embedinn/iotSDR/boards/iotSDR-IOT_Z7010/README.md

Manually edit Current Directory Path to include Remote APIs
