embedinn/iotSDR/boards/vivado_boards_files/iotSDR-Z7010/1.0/iot_SDR.jpg

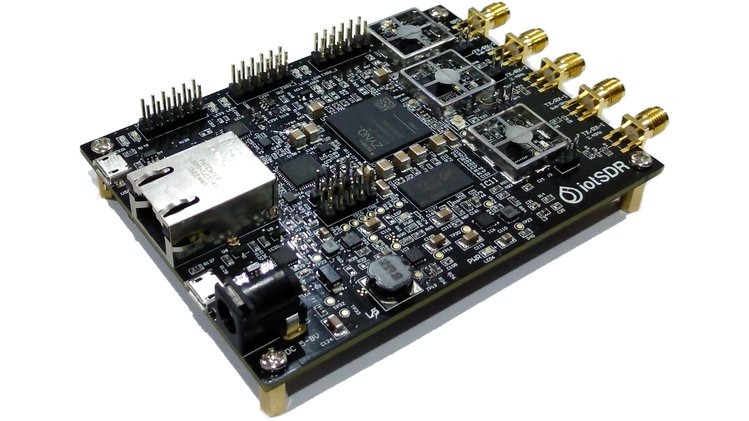
boards/vivado_boards_files/iotSDR-Z7010/1.0/iot_SDR.jpg
