embedinn/iotSDR/Support/iotSDR_BlockDesign.pdf

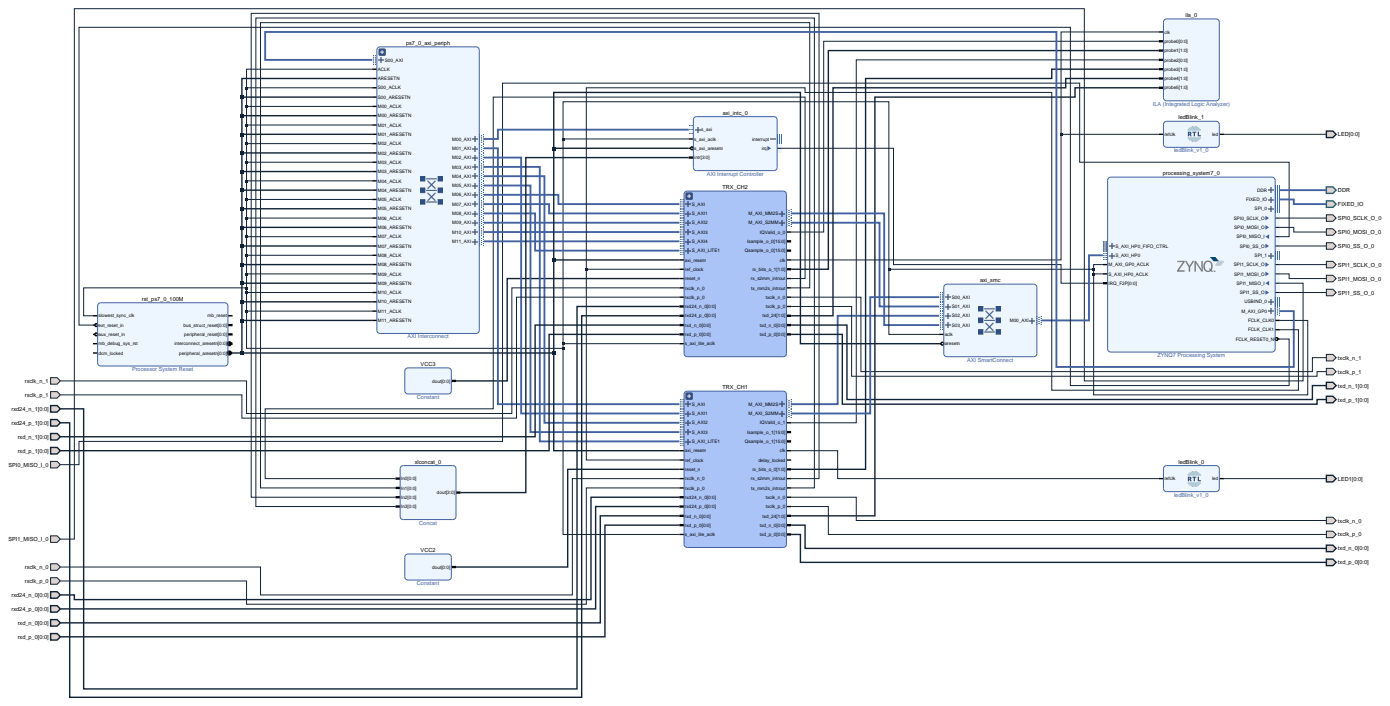
[picture p11: page 1]
DDR; FIXED_IO; LED[0:0]; LED1[0:0]; SPI0_MISO_I_0; SPI0_MOSI_O_0; SPI0_SCLK_O_0; SPI0_SS_O_0; SPI1_MISO_I_0; SPI1_MOSI_O_0; SPI1_SCLK_O_0; SPI1_SS_O_0; TRX_CH1; M_AXI_MM2S M_AXI_S2MM; S_AXI S_AXI1 S_AXI2 S_AXI3 S_AXI_LITE1; IQValid_o_1; Isample_o_1[15:0] Qsample_o_1[15:0] axi_resetn; clk; ref_clock; delay_locked; reset_n; rx_bits_o_0[1:0]; rxclk_n_0; rx_s2mm_introut; rxclk_p_0; rxd24_n_0[0:0]; rxd24_p_0[0:0]; rxd_n_0[0:0]; rxd_p_0[0:0] s_axi_lite_aclk; tx_mm2s_introut; txclk_n_0; txclk_p_0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

ILA (Integrated Logic Analyzer)

AXI Interrupt Controller

Processor System Reset
