embedinn/iotSDR/iotSDRlib/at86rf215_defs.py

# Copyright (c) 2020, embedINN
# All rights reserved.

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
# 3. Neither the name of the copyright holder nor the names of its
#    contributors may be used to endorse or promote products derived from
#    this software without specific prior written permission.

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
"""
Register identifiers for the AT86RF215 sub-GHz radio.

\author Jonathan Munoz (jonathan.munoz@inria.fr), January 2017
"""

# MACROS

IRQS_TXFE_MASK =            0x10
IRQS_TRXRDY_MASK =          0x02
IRQS_RXFS_MASK =            0x01
IRQS_RXFE_MASK =            0x02

# commands
CMD_RF_NOP =                0x0
CMD_RF_SLEEP =              0x1
CMD_RF_TRXOFF =             0x2
CMD_RF_TXPREP =             0x3
CMD_RF_TX =                 0x4
CMD_RF_RX =                 0x5
CMD_RF_RESET =              0x7
CMD_RF_IQ_MODE =            (0x1 << 4) 

# states
RF_STATE_TRXOFF =           0x2
RF_STATE_TXPREP =           0x3
RF_STATE_TX =               0x4
RF_STATE_RX =               0x5
RF_STATE_TRANSITION =       0x6
RF_STATE_RESET =            0x7

# Radio IRQ Status
IRQS_WAKEUP =               0x01
IRQS_TRXRDY =               0x02
IRQS_EDC =                  0x04
IRQS_BATLOW =               0x08
IRQS_TRXERR =               0x10
IRQS_IQIFSF =               0x20

# baseband IRQ Status
IRQS_RXFS =                 0x01
IRQS_RXFE =                 0x02
IRQS_RXAM =                 0x04
IRQS_RXEM =                 0x08
IRQS_TXFE =                 0x10
IRQS_AGCH =                 0x20
IRQS_AGCR =                 0x40
IRQS_FBLI =                 0x80

# reset command
RST_CMD =                   0x07

# register addresses (16-bit)

RG_RF09_IRQS =              [0x00, 0x00]
RG_RF24_IRQS =              [0x00, 0x01]
RG_BBC0_IRQS =              [0x00, 0x02]
RG_BBC1_IRQS =              [0x00, 0x03]
RG_RF_RST =                 [0x00, 0x05]
RG_RF_CFG =                 [0x00, 0x06]
RG_RF_CLKO =                [0x00, 0x07]
RG_RF_BMDVC =               [0x00, 0x08]
RG_RF_XOC =                 [0x00, 0x09]
RG_RF_IQIFC0 =              [0x00, 0x0A]
RG_RF_IQIFC1 =              [0x00, 0x0B]
RG_RF_IQIFC2 =              [0x00, 0x0C]
RG_RF_PN =                  [0x00, 0x0D]
RG_RF_VN =                  [0x00, 0x0E]

RG_RF09_IRQM =              [0x01, 0x00]
RG_RF09_AUXS =              [0x01, 0x01]
RG_RF09_STATE =             [0x01, 0x02]
RG_RF09_CMD =               [0x01, 0x03]
RG_RF24_CMD =               [0x02, 0x03]
RG_RF09_CS =                [0x01, 0x04]
RG_RF09_CCF0L =             [0x01, 0x05]
RG_RF09_CCF0H =             [0x01, 0x06]
RG_RF09_CNL =               [0x01, 0x07]
RG_RF09_CNM =               [0x01, 0x08]
RG_RF09_RXBWC =             [0x01, 0x09]
RG_RF09_RXDFE =             [0x01, 0x0A]
RG_RF09_AGCC =              [0x01, 0x0B]
RG_RF09_AGCS =              [0x01, 0x0C]
RG_RF09_RSSI =              [0x01, 0x0D]
RG_RF09_EDC =               [0x01, 0x0E]
RG_RF09_EDD =               [0x01, 0x0F]
RG_RF09_EDV =               [0x01, 0x10]
RG_RF09_RNDV =              [0x01, 0x11]
RG_RF09_TXCUTC =            [0x01, 0x12]
RG_RF09_TXDFE =             [0x01, 0x13]
RG_RF09_PAC =               [0x01, 0x14]

RG_RF24_IRQM =              [0x02, 0x00]
RG_RF24_AUXS =              [0x02, 0x01]
RG_RF24_STATE =             [0x02, 0x02]
RG_RF24_CMD =               [0x02, 0x03]
RG_RF24_CS =                [0x02, 0x04]
RG_RF24_CCF0L =             [0x02, 0x05]
RG_RF24_CCF0H =             [0x02, 0x06]
RG_RF24_CNL =               [0x02, 0x07]
RG_RF24_CNM =               [0x02, 0x08]
RG_RF24_RXBWC =             [0x02, 0x09]
RG_RF24_RXDFE =             [0x02, 0x0A]
RG_RF24_AGCC =              [0x02, 0x0B]
RG_RF24_AGCS =              [0x02, 0x0C]
RG_RF24_RSSI =              [0x02, 0x0D]
RG_RF24_EDC =               [0x02, 0x0E]
RG_RF24_EDD =               [0x02, 0x0F]
RG_RF24_EDV =               [0x02, 0x10]
RG_RF24_RNDV =              [0x02, 0x11]
RG_RF24_TXCUTC =            [0x02, 0x12]
RG_RF24_TXDFE =             [0x02, 0x13]
RG_RF24_PAC =               [0x02, 0x14]

RG_BBC0_IRQM =              [0x03, 0x00]
RG_BBC0_PC =                [0x03, 0x01]
RG_BBC0_PS =                [0x03, 0x02]
RG_BBC0_RXFLL =             [0x03, 0x04]
RG_BBC0_RXFLH =             [0x03, 0x05]
RG_BBC0_TXFLL =             [0x03, 0x06]
RG_BBC0_TXFLH =             [0x03, 0x07]
RG_BBC0_FBLL =              [0x03, 0x08]
RG_BBC0_FBLH =              [0x03, 0x09]
RG_BBC0_FBLIL =             [0x03, 0x0A]
RG_BBC0_FBLIH =             [0x03, 0x0B]

RG_BBC0_OFDMPHRTX =         [0x03, 0x0C]
RG_BBC0_OFDMPHRRX =         [0x03, 0x0D]
RG_BBC0_OFDMC =             [0x03, 0x0E]
RG_BBC0_OFDMSW =            [0x03, 0x0F]
RG_BBC0_OQPSKC0 =           [0x03, 0x10]
RG_BBC0_OQPSKC1 =           [0x03, 0x11]
RG_BBC0_OQPSKC2 =           [0x03, 0x12]
RG_BBC0_OQPSKC3 =           [0x03, 0x13]
RG_BBC0_OQPSKPHRTX =        [0x03, 0x14]
RG_BBC0_OQPSKPHRRX =        [0x03, 0x15]
RG_BBC0_FSKC0 =             [0x03, 0x60]
RG_BBC0_FSKC1 =             [0x03, 0x61]
RG_BBC0_FSKC2 =             [0x03, 0x62]
RG_BBC0_FSKC3 =             [0x03, 0x63]
RG_BBC0_FSKC4 =             [0x03, 0x64]
RG_BBC0_FSKPHRTX =          [0x03, 0x6A]
RG_BBC0_FSKPHRRX =          [0x03, 0x6B]
RG_BBC0_FSKDM =             [0x03, 0x72]
RG_BBC0_FSKPE0 =            [0x03, 0x73]
RG_BBC0_FSKPE1 =            [0x03, 0x74]
RG_BBC0_FSKPE2 =            [0x03, 0x75]
RG_BBC0_FSKSDF0L =          [0x03, 0x66]
RG_BBC0_FSKSDF0H =          [0x03, 0x67]
RG_BBC0_FSKSDF1L =          [0x03, 0x68]
RG_BBC0_FSKSDF1H =          [0x03, 0x69]


RG_BBC1_IRQM =              [0x04, 0x00]
RG_BBC1_PC =                [0x04, 0x01]
RG_BBC1_PS =                [0x04, 0x02]
RG_BBC1_RXFLL =             [0x04, 0x04]
RG_BBC1_RXFLH =             [0x04, 0x05]
RG_BBC1_TXFLL =             [0x04, 0x06]
RG_BBC1_TXFLH =             [0x04, 0x07]
RG_BBC1_FBLL =              [0x04, 0x08]
RG_BBC1_FBLH =              [0x04, 0x09]
RG_BBC1_FBLIL =             [0x04, 0x0A]
RG_BBC1_FBLIH =             [0x04, 0x0B]

RG_BBC1_OFDMPHRTX =         [0x04, 0x0C]
RG_BBC1_OFDMPHRRX =         [0x04, 0x0D]
RG_BBC1_OFDMC =             [0x04, 0x0E]
RG_BBC1_OFDMSW =            [0x04, 0x0F]
RG_BBC1_OQPSKC0 =           [0x04, 0x10]
RG_BBC1_OQPSKC1 =           [0x04, 0x11]
RG_BBC1_OQPSKC2 =           [0x04, 0x12]
RG_BBC1_OQPSKC3 =           [0x04, 0x13]
RG_BBC1_OQPSKPHRTX =        [0x04, 0x14]
RG_BBC1_OQPSKPHRRX =        [0x04, 0x15]
RG_BBC1_FSKC0 =             [0x04, 0x60]
RG_BBC1_FSKC1 =             [0x04, 0x61]
RG_BBC1_FSKC2 =             [0x04, 0x62]
RG_BBC1_FSKC3 =             [0x04, 0x63]
RG_BBC1_FSKC4 =             [0x04, 0x64]
RG_BBC1_FSKPHRTX =          [0x04, 0x6A]
RG_BBC1_FSKPHRRX =          [0x04, 0x6B]
RG_BBC1_FSKDM =             [0x04, 0x72]
RG_BBC1_FSKPE0 =            [0x04, 0x73]
RG_BBC1_FSKPE1 =            [0x04, 0x74]
RG_BBC1_FSKPE2 =            [0x04, 0x75]
RG_BBC1_FSKSDF0L =          [0x04, 0x66]
RG_BBC1_FSKSDF0H =          [0x04, 0x67]
RG_BBC1_FSKSDF1L =          [0x04, 0x68]
RG_BBC1_FSKSDF1H =          [0x04, 0x69]

RG_BBC0_FBRXS =             [0x20, 0x00]
RG_BBC0_FBRXE =             [0x27, 0xFE]
RG_BBC0_FBTXS =             [0x28, 0x00]
RG_BBC0_FBTXE =             [0x2F, 0xFE]

RG_BBC1_FBRXS =             [0x30, 0x00]
RG_BBC1_FBRXE =             [0x37, 0xFE]
RG_BBC1_FBTXS =             [0x38, 0x00]
RG_BBC1_FBTXE =             [0x3F, 0xFE]

OFDMPHRRX_MCS_MASK =        0x07

modulations_settings_ch_spacing = {
    '2fsk_50kbps_FEC_200kHz'     : [200, 863125],
    '2fsk_100kbps_FEC_400kHz'    : [400, 863225],
    '4fsk_200kbps_FEC_400kHz'    : [400, 863225],
    '2fsk_50kbps_200kHz'         : [200,863125],
    '2fsk_100kbps_400kHz'        : [400,863225],
    '4fsk_200kbps_400kHz'        : [400,863225],
    'ofdm_100kbps_1200kHz_mcs0'  : [1200,863625],
    'ofdm_200kbps_1200kHz_mcs1'  : [1200,863625],
    'ofdm_400kbps_1200kHz_mcs2'  : [1200,863625],
    'ofdm_800kbps_1200kHz_mcs3'  : [1200,863625],
    'ofdm_50kbps_800kHz_mcs0'    : [800,863425],
    'ofdm_100kbps_800kHz_mcs1'   : [800,863425],
    'ofdm_200kbps_800kHz_mcs2'   : [800,863425],
    'ofdm_400kbps_800kHz_mcs3'   : [800,863425],
    'ofdm_600kbps_800kHz_mcs4'   : [800,863425],
    'ofdm_800kbps_800kHz_mcs5'   : [800,863425],
    'ofdm_50kbps_400kHz_mcs1'    : [400,863225],
    'ofdm_100kbps_400kHz_mcs2'   : [400,863225],
    'ofdm_200kbps_400kHz_mcs3'   : [400,863225],
    'ofdm_300kbps_400kHz_mcs4'   : [400,863225],
    'ofdm_400kbps_400kHz_mcs5'   : [400,863225],
    'ofdm_600kbps_400kHz_mcs6'   : [400,863225],
    'ofdm_50kbps_200kHz_mcs2'    : [200,863125],
    'ofdm_100kbps_200kHz_mcs3'   : [200,863125],
    'ofdm_150kbps_200kHz_mcs4'   : [200,863125],
    'ofdm_200kbps_200kHz_mcs5'   : [200,863125],
    'ofdm_300kbps_200kHz_mcs6'   : [200,863125],
    'oqpsk_6.25kbps_600kHz'      : [100,868300], # I had 600 kHz, but I think it is wrong
    'oqpsk_12.5kbps_600kHz'      : [100,868300], #, I had 600 kHz, but I think it is wrong
    'oqpsk_25kbps_600kHz'        : [100,868300], # I had 600 kHz, but I think it is wrong
    'oqpsk_50kbps_600kHz'        : [100,868300]  # I had 600 kHz, but I think it is wrong
    }

modulations_settings = {
    # fsk_option1_FEC
    '2fsk_50kbps_FEC_200kHz': [
        (RG_RF09_CMD,           0x02),  # we make sure we are in the trxoff state
        (RG_RF09_IRQM,          0x1F),  # TRXERR, BATLOW, EDC, TRXRDY, WAKEUP interrupts enabled
        (RG_RF24_IRQM,          0x00),
        (RG_RF09_RXBWC,         0x00),
        (RG_RF09_RXDFE,         0x2A),  # RCUT = 1, bits 5-7. bit 4 not used.
        (RG_RF09_AGCC,          0x01),
        (RG_RF09_AGCS,          0x37),
        (RG_RF09_EDD,           0x7A),
        (RG_RF09_TXCUTC,        0xC0),
        (RG_RF09_TXDFE,         0x98),
        (RG_RF09_PAC,           0x74),  # // Tx Power 5 bits >>. 0x64 = txPwr=>0x04, max: 0x1F. 0x14~8 dBm
        (RG_BBC0_IRQM,          0x12),  # TXFE, RXFE, interrupts enabled
        (RG_BBC1_IRQM,          0x00),
        (RG_BBC0_PC,            0x15),  # // NO FCS FILTER in RX, FCS automatically added in TX, 32 bits FCS, FSK.
        (RG_BBC0_FSKDM,         0x01),  # //Direct modulation enabled and Pre-emphasis disabled.
        (RG_BBC0_FSKC0,         0xD6),
        (RG_BBC0_FSKC1,         0x00),
        # (RG_BBC0_FSKC2,         0x41),  # NRNSC and Interleaving
        (RG_BBC0_FSKC3,         0x85),
        (RG_BBC0_FSKC4,         0x0A),  # //FEC enabled. IEEE MODE
        (RG_BBC0_FSKPE0,        0x02),
        (RG_BBC0_FSKPE1,        0x03),
        (RG_BBC0_FSKPE2,        0xFC),
        (RG_BBC0_FSKPHRTX,      0x00)],

    # fsk_option2_FEC
    '2fsk_100kbps_FEC_400kHz': [
        (RG_RF09_CMD,           0x02),  # //we make sure we are in the trxoff state
        (RG_RF09_IRQM,          0x1F),  # // TRXERR, BATLOW, EDC, TRXRDY, WAKEUP interrupts enabled
        (RG_RF24_IRQM,          0x00),
        (RG_RF09_RXBWC,         0x03),
        (RG_RF09_RXDFE,         0x25),  # RCUT = 1, bits 5-7. bit 4 not used.
        (RG_RF09_AGCC,          0x01),
        (RG_RF09_AGCS,          0x37),
        (RG_RF09_EDD,           0x7A),
        (RG_RF09_TXCUTC,        0x83),
        (RG_RF09_TXDFE,         0x94),
        (RG_RF09_PAC,           0x74),  # // Tx Power 5 bits >>. 0x64 = txPwr=>0x04, max: 0x1F. 0x14~8 dBm
        (RG_BBC0_IRQM,          0x12),  # // TXFE, RXEM, RXAM, RXFE, RXFS interrupts enabled
        (RG_BBC1_IRQM,          0x00),
        (RG_BBC0_PC,            0x15),  # // NO FCS FILTER in RX, FCS automatically added in TX, 32 bits FCS, FSK.
        (RG_BBC0_FSKDM,         0x01),  # //Direct modulation enabled and Pre-emphasis disabled.
        (RG_BBC0_FSKC0,         0xD6),
        (RG_BBC0_FSKC1,         0x01),
        # (RG_BBC0_FSKC2,         0x41),  # NRNSC and Interleaving
        (RG_BBC0_FSKC3,         0x85),
        (RG_BBC0_FSKC4,         0x0A),  # //FEC enabled. IEEE MODE
        (RG_BBC0_FSKPE0,        0x0E),
        (RG_BBC0_FSKPE1,        0x0F),
        (RG_BBC0_FSKPE2,        0xF0),
        (RG_BBC0_FSKPHRTX,      0x00)],

    # fsk_option3_FEC
    '4fsk_200kbps_FEC_400kHz': [
        (RG_RF09_CMD,           0x02),  # //we make sure we are in the trxoff state
        (RG_RF09_IRQM,          0x1F),  # // TRXERR, BATLOW, EDC, TRXRDY, WAKEUP interrupts enabled
        (RG_RF24_IRQM,          0x00),
        (RG_RF09_RXBWC,         0x03),  # //IF shift, 200 kHz bandwidth
        (RG_RF09_RXDFE,         0x25),  # //find the right values
        (RG_RF09_AGCC,          0x01),
        (RG_RF09_AGCS,          0x37),
        (RG_RF09_EDD,           0x7A),
        (RG_RF09_TXCUTC,        0x83),  #
        (RG_RF09_TXDFE,         0x94),  # //find the right values
        (RG_RF09_PAC,           0x74),  # // Tx Power 5 bits >>. 0x64 = txPwr=>0x04, max: 0x1F. 0x14~8 dBm
        (RG_BBC0_IRQM,          0x12),  # // TXFE, RXFE interrupts enabled.  RXFS , RXEM, RXAM, disabled
        (RG_BBC1_IRQM,          0x00),
        (RG_BBC0_PC,            0x15),  # // NO FCS FILTER in RX, FCS automatically added in TX, 32 bits FCS, FSK.
        (RG_BBC0_FSKDM,         0x01),  # //Direct modulation enabled and Pre-emphasis disabled.
        (RG_BBC0_FSKSDF0L,      0xBE),
        (RG_BBC0_FSKSDF0H,      0xFF),
        # (RG_BBC0_FSKSDF1L,      0xAE),
        # (RG_BBC0_FSKSDF1H,      0xBF),
        (RG_BBC0_FSKC0,         0xD7),
        (RG_BBC0_FSKC1,         0x01),  #  1 = 100 kHz symbol rate, 3 = 200 kHz
        # (RG_BBC0_FSKC2,         0x41),  # NRNSC and Interleaving
        (RG_BBC0_FSKC3,         0x85),
        (RG_BBC0_FSKC4,         0x22),
        (RG_BBC0_FSKPE0,        0x0E),
        (RG_BBC0_FSKPE1,        0x0F),
        (RG_BBC0_FSKPE2,        0xF0),
        (RG_BBC0_FSKPHRTX,      0x00)],

    # fsk_option1
    '2fsk_50kbps_200kHz': [
        (RG_RF09_CMD,           0x02),  # //we make sure we are in the trxoff state
        (RG_RF09_IRQM,          0x1F),  # // TRXERR, BATLOW, EDC, TRXRDY, WAKEUP interrupts enabled
        (RG_RF24_IRQM,          0x00),
        (RG_RF09_RXBWC,         0x00), # 0 IFS, 50 kHz symbol rate
        (RG_RF09_RXDFE,         0x2A), # RCUT = 1 , SR = 10
        (RG_RF09_AGCC,          0x01),
        (RG_RF09_AGCS,          0x37),
        (RG_RF09_EDD,           0x7A),
        (RG_RF09_TXCUTC,        0xC0),
        (RG_RF09_TXDFE,         0x98),
        (RG_RF09_PAC,           0x74),  # // Tx Power 5 bits >>. 0x64 = txPwr=>0x04, max: 0x1F. 0x14~8 dBm
        (RG_BBC0_IRQM,          0x12),  # // TXFE, RXEM, RXAM, RXFE, RXFS interrupts enabled
        (RG_BBC1_IRQM,          0x00),
        (RG_BBC0_PC,            0x15),  # // NO FCS FILTER in RX, FCS automatically added in TX, 32 bits FCS, FSK.
        (RG_BBC0_FSKDM,         0x01),  # //Direct modulation enabled and Pre-emphasis disabled.
        (RG_BBC0_FSKC0,         0xD6),
        (RG_BBC0_FSKC1,         0x00),
        # (RG_BBC0_FSKC2,         0x41),  # NRNSC and Interleaving
        (RG_BBC0_FSKC3,         0x85),
        (RG_BBC0_FSKC4,         0x00),  # //FEC disabled. IEEE MODE
        (RG_BBC0_FSKPE0,        0x02),
        (RG_BBC0_FSKPE1,        0x03),
        (RG_BBC0_FSKPE2,        0xFC),
        (RG_BBC0_FSKPHRTX,      0x08)],  # using SDF 1

    # fsk_option2
    '2fsk_100kbps_400kHz': [
        (RG_RF09_CMD,           0x02),  # //we make sure we are in the trxoff state
        (RG_RF09_IRQM,          0x1F),  # // TRXERR, BATLOW, EDC, TRXRDY, WAKEUP interrupts enabled
        (RG_RF24_IRQM,          0x00),
        (RG_RF09_RXBWC,         0x03),  # 0 IFS, 100 kHz symbol rate
        (RG_RF09_RXDFE,         0x25),  # RCUT = 1 , SR = 5
        (RG_RF09_AGCC,          0x01),
        (RG_RF09_AGCS,          0x37),
        (RG_RF09_EDD,           0x7A),
        (RG_RF09_TXCUTC,        0x83),
        (RG_RF09_TXDFE,         0x94),
        (RG_RF09_PAC,           0x74),  # // Tx Power 5 bits >>. 0x64 = txPwr=>0x04, max: 0x1F. 0x14~8 dBm
        (RG_BBC0_IRQM,          0x12),  # // TXFE, RXEM, RXAM, RXFE, RXFS interrupts enabled
        (RG_BBC1_IRQM,          0x00),
        (RG_BBC0_PC,            0x15),  # // NO FCS FILTER in RX, FCS automatically added in TX, 32 bits FCS, FSK.
        (RG_BBC0_FSKDM,         0x01),  # //Direct modulation enabled and Pre-emphasis disabled.
        (RG_BBC0_FSKC0,         0xD6),
        (RG_BBC0_FSKC1,         0x01),
        # (RG_BBC0_FSKC2,         0x41),  # NRNSC and Interleaving
        (RG_BBC0_FSKC3,         0x85),
        (RG_BBC0_FSKC4,         0x00),  # //FEC disabled. IEEE MODE
        (RG_BBC0_FSKPE0,        0x0E),
        (RG_BBC0_FSKPE1,        0x0F),
        (RG_BBC0_FSKPE2,        0xF0),
        (RG_BBC0_FSKPHRTX,      0x08)],  # using SDF1

    # fsk_option3
    '4fsk_200kbps_400kHz': [
        (RG_RF09_CMD,           0x02),  # //we make sure we are in the trxoff state
        (RG_RF09_IRQM,          0x1F),  # // TRXERR, BATLOW, EDC, TRXRDY, WAKEUP interrupts enabled
        (RG_RF24_IRQM,          0x00),
        (RG_RF09_RXBWC,         0x03),  # //IFS 1, 200 kHz
        (RG_RF09_RXDFE,         0x25),  # # RCUT = 2 , SR = 4
        (RG_RF09_AGCC,          0x01),
        (RG_RF09_AGCS,          0x37),
        (RG_RF09_EDD,           0x7A),
        (RG_RF09_TXCUTC,        0x83),  #
        (RG_RF09_TXDFE,         0x94),  #
        (RG_RF09_PAC,           0x74),  # // Tx Power 5 bits >>. 0x64 = txPwr=>0x04, max: 0x1F. 0x14~8 dBm
        (RG_BBC0_IRQM,          0x12),  # // TXFE, RXEM, RXAM, RXFE, RXFS interrupts enabled
        (RG_BBC1_IRQM,          0x00),
        (RG_BBC0_PC,            0x15),  # // NO FCS FILTER in RX, FCS automatically added in TX, 32 bits FCS, FSK.
        (RG_BBC0_FSKDM,         0x01),  # //Direct modulation enabled and Preemphasis disabled.
        (RG_BBC0_FSKSDF0L,      0xEB),
        (RG_BBC0_FSKSDF0H,      0xAA),
        # (RG_BBC0_FSKSDF1L,      0xAE),
        # (RG_BBC0_FSKSDF1H,      0xBF),
        (RG_BBC0_FSKC0,         0xD7),
        (RG_BBC0_FSKC1,         0x01),  #  1 = 200 kHz symbol rate, 3 = 400 kHz
        # (RG_BBC0_FSKC2,         0x41),  # NRNSC and Interleaving
        (RG_BBC0_FSKC3,         0x85),
        (RG_BBC0_FSKC4,         0x20),  # FEC disabled
        (RG_BBC0_FSKPE0,        0x0E),
        (RG_BBC0_FSKPE1,        0x0F),
        (RG_BBC0_FSKPE2,        0xF0),
        (RG_BBC0_FSKPHRTX,      0x00)],

    # oqpsk_rate0
    'oqpsk_6.25kbps_600kHz': [
        (RG_BBC0_PC,            0x17),
        (RG_BBC0_OQPSKPHRTX,    0x00),  # MR-OQPSK, rate mode 0
        (RG_BBC0_OQPSKC0,       0x10),  # 100kchips/s, RC-0.8 shaping, direct-modulation enabled
        (RG_BBC0_OQPSKC1,       0xB8),#// MINIMUM preamble-detection sensitivity for SUN-O-QPSK, MAXIMUM for LEGACY OQPSK, rx-override enabled
        (RG_BBC0_OQPSKC2,       0x04),#// listen for MR-OQPSK frames only
        (RG_BBC0_OQPSKC3,       0x00),#// legacy OQPSK, search for SFD_1 only
        (RG_BBC0_IRQM,          0x13),  # // TXFE, RXFE, RXFS interrupts enabled
        (RG_BBC1_IRQM,          0x00),
        (RG_RF09_IRQM,          0x12),  # // TRXERR, TRXRDY interrupts enabled
        (RG_RF24_IRQM,          0x00),
        (RG_RF09_RXBWC,         0x00),  # Rx BW 160kHz, IF 250kHz
        (RG_RF09_RXDFE,         0x2A),  # //
        (RG_RF09_AGCC,          0x21),
        (RG_RF09_EDD,           0x2B),
        (RG_RF09_AGCS,          0x77),
        (RG_RF09_TXCUTC,        0xC7),  # .PARAMP = 3, .LPFCUT = 7
        (RG_RF09_TXDFE,         0x7A),  # // .SR = 0xA, .RCUT = 3
        (RG_RF09_PAC,           0x75)],  # Tx Power 5 bits >>. 0x64 = txPwr=>0x04, max: 0x1F. # 0x15~8 dBm

    # oqpsk_rate1
    'oqpsk_12.5kbps_600kHz': [
        (RG_BBC0_PC,            0x17),
        (RG_BBC0_OQPSKPHRTX,    0x02),  #  MR-OQPSK, rate mode 1
        (RG_BBC0_OQPSKC0,       0x10),  #  100kchips/s, RC-0.8 shaping, direct-modulation enabled
        (RG_BBC0_OQPSKC1,       0xB8),#// MINIMUM preamble-detection sensitivity for SUN-O-QPSK, MAXIMUM for LEGACY OQPSK, rx-override enabled
        (RG_BBC0_OQPSKC2,       0x00),  # listen for MR-OQPSK frames only
        (RG_BBC0_OQPSKC3,       0x00), #  legacy OQPSK, search for SFD_1 only
        (RG_BBC0_IRQM,          0x13),  # // TXFE, RXFE, RXFS interrupts enabled
        (RG_BBC1_IRQM,          0x00),
        (RG_RF09_IRQM,          0x12),  # // TRXERR, TRXRDY interrupts enabled
        (RG_RF24_IRQM,          0x00),
        (RG_RF09_RXBWC,         0x00),  # //  Rx BW 160kHz, IF 250kHz
        (RG_RF09_RXDFE,         0x2A),  # //
        (RG_RF09_AGCC,          0x21),
        (RG_RF09_EDD,           0x2B),
        (RG_RF09_AGCS,          0x77),
        (RG_RF09_TXCUTC,        0xC7),  # // .PARAMP = 3, .LPFCUT = 7
        (RG_RF09_TXDFE,         0x7A),  # // .SR = 0xA, .RCUT = 3
        (RG_RF09_PAC,           0x75)],  # Tx Power 5 bits >>. 0x64 = txPwr=>0x04, max: 0x1F. # 0x15~8 dBm

    # oqpsk_rate2
    'oqpsk_25kbps_600kHz': [
        (RG_BBC0_PC,            0x17),
        (RG_BBC0_OQPSKPHRTX,    0x04),  # // MR-OQPSK, rate mode 2
        (RG_BBC0_OQPSKC0,       0x10),  # // 100kchips/s, RC-0.8 shaping, direct-modulation enabled
        (RG_BBC0_OQPSKC1,       0xB8),  #// MINIMUM preamble-detection sensitivities, rx-override disabled
        (RG_BBC0_OQPSKC2,       0x04), # // listen for MR-OQPSK frames only
        (RG_BBC0_OQPSKC3,       0x00), # // legacy OQPSK, search for SFD_1 only
        (RG_BBC0_IRQM,          0x13),  # // TXFE, RXFE, RXFS interrupts enabled
        (RG_BBC1_IRQM,          0x00),
        (RG_RF09_IRQM,          0x12),  # // TRXERR, TRXRDY interrupts enabled
        (RG_RF24_IRQM,          0x00),
        (RG_RF09_RXBWC,         0x00),  # //  Rx BW 160kHz, IF 250kHz
        (RG_RF09_RXDFE,         0x2A),  # //
        (RG_RF09_AGCC,          0x21),
        (RG_RF09_EDD,           0x2B),
        (RG_RF09_AGCS,          0x77),
        (RG_RF09_TXCUTC,        0xC7),  # # .PARAMP = 3, .LPFCUT = 7
        (RG_RF09_TXDFE,         0x7A),  # # .SR = 0xA, .RCUT = 3
        (RG_RF09_PAC,           0x75)],  # Tx Power 5 bits >>. 0x64 = txPwr=>0x04, max: 0x1F. # 0x15~8 dBm

    # oqpsk_rate3
    'oqpsk_50kbps_600kHz': [
        (RG_BBC0_PC,            0x17),
        (RG_BBC0_OQPSKPHRTX,    0x06),  # # MR-OQPSK, rate mode 3
        (RG_BBC0_OQPSKC0,       0x10),  ## 100kchips/s, RC-0.8 shaping, direct-modulation enabled
        (RG_BBC0_OQPSKC1,       0xB8),  # MINIMUM preamble-detection sensitivities, rx-override disabled
        (RG_BBC0_OQPSKC2,       0x00),  # listen for MR-OQPSK frames only
        (RG_BBC0_OQPSKC3,       0x00),  # legacy OQPSK, search for SFD_1 only
        (RG_BBC0_IRQM,          0x13),  # # TXFE, RXFE, RXFS interrupts enabled
        (RG_BBC1_IRQM,          0x00),
        (RG_RF09_IRQM,          0x12),  # # TRXERR, TRXRDY interrupts enabled
        (RG_RF24_IRQM,          0x00),
        (RG_RF09_RXBWC,         0x00),  # #  Rx BW 160kHz, IF 250kHz
        (RG_RF09_RXDFE,         0x2A),  # #
        (RG_RF09_AGCC,          0x21),
        (RG_RF09_EDD,           0x2B),
        (RG_RF09_AGCS,          0x77),
        (RG_RF09_TXCUTC,        0xC7),  # # .PARAMP = 3, .LPFCUT = 7
        (RG_RF09_TXDFE,         0x7A),  # # .SR = 0xA, .RCUT = 3
        (RG_RF09_PAC,           0x75)],  # Tx Power 5 bits >>. 0x64 = txPwr=>0x04, max: 0x1F. # 0x15~8 dBm

    # subGHz_ofdm_1_mcs0
    'subGHz_ofdm_100kbps_1200kHz_mcs0': [
        (RG_RF09_CMD,           0x02),
        (RG_RF09_IRQM,          0x1F),
        (RG_RF24_IRQM,          0x00),
        (RG_RF09_RXBWC,         0x19),
        (RG_RF09_RXDFE,         0x83),
        # (RG_RF09_AGCC,          0x11),
        (RG_RF09_EDD,           0x7A),
        (RG_RF09_TXCUTC,        0x0A),  # recommended value (0x0B)
        (RG_RF09_TXDFE,         0x83),
        (RG_RF09_PAC,           0x7D),  # Tx Power 5 bits >>. 0x64 = txPwr=>0x04, max: 0x1F. # 0x1D~8dBm
        (RG_BBC0_IRQM,          0x12),
        (RG_BBC1_IRQM,          0x00),
        (RG_BBC0_PC,            0x16),  # NO FCS FILTER in RX, FCS automatically added in TX
        (RG_BBC0_OFDMC,         0x00),
        (RG_BBC0_OFDMPHRTX,     0x00)],

    # subGHz_ofdm_1_mcs1
    'subGHz_ofdm_200kbps_1200kHz_mcs1': [
        (RG_RF09_CMD,           0x02),
        (RG_RF09_IRQM,          0x1F),
        (RG_RF24_IRQM,          0x00),
        (RG_RF09_RXBWC,         0x19),
        (RG_RF09_RXDFE,         0x83),
        # (RG_RF09_AGCC,          0x11),
        (RG_RF09_EDD,           0x7A),
        (RG_RF09_TXCUTC,        0x0A),  # recommended value (0x0B)
        (RG_RF09_TXDFE,         0x83),
        (RG_RF09_PAC,           0x7D),  # Tx Power 5 bits >>. 0x64 = txPwr=>0x04, max: 0x1F. # 0x1D~8dBm
        (RG_BBC0_IRQM,          0x12),
        (RG_BBC1_IRQM,          0x00),
        (RG_BBC0_PC,            0x16),  # NO FCS FILTER in RX, FCS automatically added in TX
        (RG_BBC0_OFDMC,         0x00),
        (RG_BBC0_OFDMPHRTX,     0x01)],

    # subGHz_ofdm_1_mcs2
    'subGHz_ofdm_400kbps_1200kHz_mcs2': [
        (RG_RF09_CMD,           0x02),
        (RG_RF09_IRQM,          0x1F),
        (RG_RF24_IRQM,          0x00),
        (RG_RF09_RXBWC,         0x19),
        (RG_RF09_RXDFE,         0x83),
        # (RG_RF09_AGCC,          0x11),
        (RG_RF09_EDD,           0x7A),
        (RG_RF09_TXCUTC,        0x0A),  # recommended value (0x0B)
        (RG_RF09_TXDFE,         0x83),
        (RG_RF09_PAC,           0x7D),  # Tx Power 5 bits >>. 0x64 = txPwr=>0x04, max: 0x1F. # 0x1D~8dBm
        (RG_BBC0_IRQM,          0x12),
        (RG_BBC1_IRQM,          0x00),
        (RG_BBC0_PC,            0x16),  # NO FCS FILTER in RX, FCS automatically added in TX
        (RG_BBC0_OFDMC,         0x00),
        (RG_BBC0_OFDMPHRTX,     0x02)],

    # subGHz_ofdm_1_mcs3
    'subGHz_ofdm_800kbps_1200kHz_mcs3': [
        (RG_RF09_CMD,           0x02),
        (RG_RF09_IRQM,          0x1F),
        (RG_RF24_IRQM,          0x00),
        (RG_RF09_RXBWC,         0x19),
        (RG_RF09_RXDFE,         0x83),
        # (RG_RF09_AGCC,          0x11),
        (RG_RF09_EDD,           0x7A),
        (RG_RF09_TXCUTC,        0x0A),  # recommended value (0x0B)
        (RG_RF09_TXDFE,         0x83),
        (RG_RF09_PAC,           0x7D),  # Tx Power 5 bits >>. 0x64 = txPwr=>0x04, max: 0x1F. # 0x1D~8dBm
        (RG_BBC0_IRQM,          0x12),
        (RG_BBC1_IRQM,          0x00),
        (RG_BBC0_PC,            0x16),  # NO FCS FILTER in RX, FCS automatically added in TX
        (RG_BBC0_OFDMC,         0x00),
        (RG_BBC0_OFDMPHRTX,     0x03)],

    # subGHz_ofdm_2_mcs0
    'subGHz_ofdm_50kbps_800kHz_mcs0': [
        (RG_RF09_CMD,           0x02),
        (RG_RF09_IRQM,          0x1F),
        (RG_RF24_IRQM,          0x00),
        (RG_RF09_RXBWC,         0x17),
        (RG_RF09_RXDFE,         0x43),
        # (RG_RF09_AGCC,          0x11),
        (RG_RF09_EDD,           0x7A),
        (RG_RF09_TXCUTC,        0x08),  # recommended value ()
        (RG_RF09_TXDFE,         0x63),
        (RG_RF09_PAC,           0x7C),  # Tx Power 5 bits >>. 0x64 = txPwr=>0x04, max: 0x1F. # 0x1C~8dBm
        (RG_BBC0_IRQM,          0x12),
        (RG_BBC1_IRQM,          0x00),
        (RG_BBC0_PC,            0x16),  # NO FCS FILTER in RX, FCS automatically added in TX
        (RG_BBC0_OFDMC,         0x01),
        (RG_BBC0_OFDMPHRTX,     0x00)],

    # subGHz_ofdm_2_mcs1
    'subGHz_ofdm_100kbps_800kHz_mcs1': [
        (RG_RF09_CMD,           0x02),
        (RG_RF09_IRQM,          0x1F),
        (RG_RF24_IRQM,          0x00),
        (RG_RF09_RXBWC,         0x17),
        (RG_RF09_RXDFE,         0x43),
        # (RG_RF09_AGCC,          0x11),
        (RG_RF09_EDD,           0x7A),
        (RG_RF09_TXCUTC,        0x08),  # recommended value ()
        (RG_RF09_TXDFE,         0x63),
        (RG_RF09_PAC,           0x7C),  # Tx Power 5 bits >>. 0x64 = txPwr=>0x04, max: 0x1F. # 0x1C~8dBm
        (RG_BBC0_IRQM,          0x12),
        (RG_BBC1_IRQM,          0x00),
        (RG_BBC0_PC,            0x16),  # NO FCS FILTER in RX, FCS automatically added in TX
        (RG_BBC0_OFDMC,         0x01),
        (RG_BBC0_OFDMPHRTX,     0x01)],

    # subGHz_ofdm_2_mcs2
    'subGHz_ofdm_200kbps_800kHz_mcs2': [
        (RG_RF09_CMD,           0x02),
        (RG_RF09_IRQM,          0x1F),
        (RG_RF24_IRQM,          0x00),
        (RG_RF09_RXBWC,         0x17),
        (RG_RF09_RXDFE,         0x43),
        # (RG_RF09_AGCC,          0x11),
        (RG_RF09_EDD,           0x7A),
        (RG_RF09_TXCUTC,        0x08),  # recommended value ()
        (RG_RF09_TXDFE,         0x63),
        (RG_RF09_PAC,           0x7C),  # Tx Power 5 bits >>. 0x64 = txPwr=>0x04, max: 0x1F. # 0x1C~8dBm
        (RG_BBC0_IRQM,          0x12),
        (RG_BBC1_IRQM,          0x00),
        (RG_BBC0_PC,            0x16),  # NO FCS FILTER in RX, FCS automatically added in TX
        (RG_BBC0_OFDMC,         0x01),
        (RG_BBC0_OFDMPHRTX,     0x02)],

    # subGHz_ofdm_2_mcs3
    'subGHz_ofdm_400kbps_800kHz_mcs3': [
        (RG_RF09_CMD,           0x02),
        (RG_RF09_IRQM,          0x1F),
        (RG_RF24_IRQM,          0x00),
        (RG_RF09_RXBWC,         0x17),
        (RG_RF09_RXDFE,         0x43),
        # (RG_RF09_AGCC,          0x11),
        (RG_RF09_EDD,           0x7A),
        (RG_RF09_TXCUTC,        0x08),  # recommended value ()
        (RG_RF09_TXDFE,         0x63),
        (RG_RF09_PAC,           0x7C),  # Tx Power 5 bits >>. 0x64 = txPwr=>0x04, max: 0x1F. # 0x1C~8dBm
        (RG_BBC0_IRQM,          0x12),
        (RG_BBC1_IRQM,          0x00),
        (RG_BBC0_PC,            0x16),  # NO FCS FILTER in RX, FCS automatically added in TX
        (RG_BBC0_OFDMC,         0x01),
        (RG_BBC0_OFDMPHRTX,     0x03)],

    # subGHz_ofdm_2_mcs4
    'subGHz_ofdm_600kbps_800kHz_mcs4': [
        (RG_RF09_CMD,           0x02),
        (RG_RF09_IRQM,          0x1F),
        (RG_RF24_IRQM,          0x00),
        (RG_RF09_RXBWC,         0x17),
        (RG_RF09_RXDFE,         0x43),
        # (RG_RF09_AGCC,          0x11),
        (RG_RF09_EDD,           0x7A),
        (RG_RF09_TXCUTC,        0x08),  # recommended value ()
        (RG_RF09_TXDFE,         0x63),
        (RG_RF09_PAC,           0x7C),  # Tx Power 5 bits >>. 0x64 = txPwr=>0x04, max: 0x1F. # 0x1C~8dBm
        (RG_BBC0_IRQM,          0x12),
        (RG_BBC1_IRQM,          0x00),
        (RG_BBC0_PC,            0x16),  # NO FCS FILTER in RX, FCS automatically added in TX
        (RG_BBC0_OFDMC,         0x01),
        (RG_BBC0_OFDMPHRTX,     0x04)],

    # subGHz_ofdm_2_mcs5
    'subGHz_ofdm_800kbps_800kHz_mcs5': [
        (RG_RF09_CMD,           0x02),
        (RG_RF09_IRQM,          0x1F),
        (RG_RF24_IRQM,          0x00),
        (RG_RF09_RXBWC,         0x17),
        (RG_RF09_RXDFE,         0x43),
        # (RG_RF09_AGCC,          0x11),
        (RG_RF09_EDD,           0x7A),
        (RG_RF09_TXCUTC,        0x08),  # recommended value ()
        (RG_RF09_TXDFE,         0x63),
        (RG_RF09_PAC,           0x7C),  # Tx Power 5 bits >>. 0x64 = txPwr=>0x04, max: 0x1F. # 0x1C~8dBm
        (RG_BBC0_IRQM,          0x12),
        (RG_BBC1_IRQM,          0x00),
        (RG_BBC0_PC,            0x16),  # NO FCS FILTER in RX, FCS automatically added in TX
        (RG_BBC0_OFDMC,         0x01),
        (RG_BBC0_OFDMPHRTX,     0x05)],

    # subGHz_ofdm_3_mcs1
    'subGHz_ofdm_50kbps_400kHz_mcs1': [
        (RG_RF09_CMD,           0x02),
        (RG_RF09_IRQM,          0x1F),
        (RG_RF24_IRQM,          0x00),
        (RG_RF09_RXBWC,         0x04),
        (RG_RF09_RXDFE,         0x46),
        # (RG_RF09_AGCC,          0x11),
        (RG_RF09_EDD,           0x7A),
        (RG_RF09_TXCUTC,        0x05),  # recommended value ()
        (RG_RF09_TXDFE,         0x66),
        (RG_RF09_PAC,           0x7D),  # Tx Power 5 bits >>. 0x64 = txPwr=>0x04, max: 0x1F. # 0x1D~8dBm
        (RG_BBC0_IRQM,          0x12),
        (RG_BBC1_IRQM,          0x00),
        (RG_BBC0_PC,            0x16),  # NO FCS FILTER in RX, FCS automatically added in TX
        (RG_BBC0_OFDMC,         0x02),
        (RG_BBC0_OFDMPHRTX,     0x01)],

    # subGHz_ofdm_3_mcs2
    'subGHz_ofdm_100kbps_400kHz_mcs2': [
        (RG_RF09_CMD,           0x02),
        (RG_RF09_IRQM,          0x1F),
        (RG_RF24_IRQM,          0x00),
        (RG_RF09_RXBWC,         0x04),
        (RG_RF09_RXDFE,         0x46),
        # (RG_RF09_AGCC,          0x11),
        (RG_RF09_EDD,           0x7A),
        (RG_RF09_TXCUTC,        0x05),  # recommended value ()
        (RG_RF09_TXDFE,         0x66),
        (RG_RF09_PAC,           0x7D),  # Tx Power 5 bits >>. 0x64 = txPwr=>0x04, max: 0x1F. # 0x1D~8dBm
        (RG_BBC0_IRQM,          0x12),
        (RG_BBC1_IRQM,          0x00),
        (RG_BBC0_PC,            0x16),  # NO FCS FILTER in RX, FCS automatically added in TX
        (RG_BBC0_OFDMC,         0x02),
        (RG_BBC0_OFDMPHRTX,     0x02)],

    # subGHz_ofdm_3_mcs3
    'subGHz_ofdm_200kbps_400kHz_mcs3': [
        (RG_RF09_CMD,           0x02),
        (RG_RF09_IRQM,          0x1F),
        (RG_RF24_IRQM,          0x00),
        (RG_RF09_RXBWC,         0x04),
        (RG_RF09_RXDFE,         0x46),
        # (RG_RF09_AGCC,          0x11),
        (RG_RF09_EDD,           0x7A),
        (RG_RF09_TXCUTC,        0x05),  # recommended value ()
        (RG_RF09_TXDFE,         0x66),
        (RG_RF09_PAC,           0x7D),  # Tx Power 5 bits >>. 0x64 = txPwr=>0x04, max: 0x1F. # 0x1D~8dBm
        (RG_BBC0_IRQM,          0x12),
        (RG_BBC1_IRQM,          0x00),
        (RG_BBC0_PC,            0x16),  # NO FCS FILTER in RX, FCS automatically added in TX
        (RG_BBC0_OFDMC,         0x02),
        (RG_BBC0_OFDMPHRTX,     0x03)],

    # subGHz_ofdm_3_mcs4
    'subGHz_ofdm_300kbps_400kHz_mcs4': [
        (RG_RF09_CMD,           0x02),
        (RG_RF09_IRQM,          0x1F),
        (RG_RF24_IRQM,          0x00),
        (RG_RF09_RXBWC,         0x04),
        (RG_RF09_RXDFE,         0x46),
        # (RG_RF09_AGCC,          0x11),
        (RG_RF09_EDD,           0x7A),
        (RG_RF09_TXCUTC,        0x05),  # recommended value ()
        (RG_RF09_TXDFE,         0x66),
        (RG_RF09_PAC,           0x7D),  # Tx Power 5 bits >>. 0x64 = txPwr=>0x04, max: 0x1F. # 0x1D~8dBm
        (RG_BBC0_IRQM,          0x12),
        (RG_BBC1_IRQM,          0x00),
        (RG_BBC0_PC,            0x16),  # NO FCS FILTER in RX, FCS automatically added in TX
        (RG_BBC0_OFDMC,         0x02),
        (RG_BBC0_OFDMPHRTX,     0x04)],

    # subGHz_ofdm_3_mcs5
    'subGHz_ofdm_400kbps_400kHz_mcs5': [
        (RG_RF09_CMD,           0x02),
        (RG_RF09_IRQM,          0x1F),
        (RG_RF24_IRQM,          0x00),
        (RG_RF09_RXBWC,         0x04),
        (RG_RF09_RXDFE,         0x46),
        # (RG_RF09_AGCC,          0x11),
        (RG_RF09_EDD,           0x7A),
        (RG_RF09_TXCUTC,        0x05),  # recommended value ()
        (RG_RF09_TXDFE,         0x66),
        (RG_RF09_PAC,           0x7D),  # Tx Power 5 bits >>. 0x64 = txPwr=>0x04, max: 0x1F. # 0x1D~8dBm
        (RG_BBC0_IRQM,          0x12),
        (RG_BBC1_IRQM,          0x00),
        (RG_BBC0_PC,            0x16),  # NO FCS FILTER in RX, FCS automatically added in TX
        (RG_BBC0_OFDMC,         0x02),
        (RG_BBC0_OFDMPHRTX,     0x05)],

    # subGHz_ofdm_3_mcs6
    'subGHz_ofdm_600kbps_400kHz_mcs6': [
        (RG_RF09_CMD,           0x02),
        (RG_RF09_IRQM,          0x1F),
        (RG_RF24_IRQM,          0x00),
        (RG_RF09_RXBWC,         0x04),
        (RG_RF09_RXDFE,         0x46),
        # (RG_RF09_AGCC,          0x11),
        (RG_RF09_EDD,           0x7A),
        (RG_RF09_TXCUTC,        0x05),  # recommended value ()
        (RG_RF09_TXDFE,         0x66),
        (RG_RF09_PAC,           0x7D),  # Tx Power 5 bits >>. 0x64 = txPwr=>0x04, max: 0x1F. # 0x1D~8dBm
        (RG_BBC0_IRQM,          0x12),
        (RG_BBC1_IRQM,          0x00),
        (RG_BBC0_PC,            0x16),  # NO FCS FILTER in RX, FCS automatically added in TX
        (RG_BBC0_OFDMC,         0x02),
        (RG_BBC0_OFDMPHRTX,     0x06)],

    # subGHz_ofdm_4_mcs2
    'subGHz_ofdm_50kbps_200kHz_mcs2': [
        (RG_RF09_CMD,           0x02),
        (RG_RF09_IRQM,          0x1F),
        (RG_RF24_IRQM,          0x00),
        (RG_RF09_RXBWC,         0x12),
        (RG_RF09_RXDFE,         0x26),
        # (RG_RF09_AGCC,          0x11),
        (RG_RF09_EDD,           0x7A),
        (RG_RF09_TXCUTC,        0x03),  # recommended value ()
        (RG_RF09_TXDFE,         0x46),
        (RG_RF09_PAC,           0x7B),  # Tx Power 5 bits >>. 0x64 = txPwr=>0x04, max: 0x1F. # 0x1B~8dBm
        (RG_BBC0_IRQM,          0x12),
        (RG_BBC1_IRQM,          0x00),
        (RG_BBC0_PC,            0x16),  # NO FCS FILTER in RX, FCS automatically added in TX
        (RG_BBC0_OFDMC,         0x03),
        (RG_BBC0_OFDMPHRTX,     0x02)],

    # subGHz_ofdm_4_mcs3
    'subGHz_ofdm_100kbps_200kHz_mcs3': [
        (RG_RF09_CMD,           0x02),
        (RG_RF09_IRQM,          0x1F),
        (RG_RF24_IRQM,          0x00),
        (RG_RF09_RXBWC,         0x12),
        (RG_RF09_RXDFE,         0x26),
        # (RG_RF09_AGCC,          0x11),
        (RG_RF09_EDD,           0x7A),
        (RG_RF09_TXCUTC,        0x03),  # recommended value ()
        (RG_RF09_TXDFE,         0x46),
        (RG_RF09_PAC,           0x7B),  # Tx Power 5 bits >>. 0x64 = txPwr=>0x04, max: 0x1F. # 0x1B~8dBm
        (RG_BBC0_IRQM,          0x12),
        (RG_BBC1_IRQM,          0x00),
        (RG_BBC0_PC,            0x16),  # NO FCS FILTER in RX, FCS automatically added in TX
        (RG_BBC0_OFDMC,         0x03),
        (RG_BBC0_OFDMPHRTX,     0x03)],

    # subGHz_ofdm_4_mcs4
    'subGHz_ofdm_150kbps_200kHz_mcs4': [
        (RG_RF09_CMD,           0x02),
        (RG_RF09_IRQM,          0x1F),
        (RG_RF24_IRQM,          0x00),
        (RG_RF09_RXBWC,         0x12),
        (RG_RF09_RXDFE,         0x26),
        # (RG_RF09_AGCC,          0x11),
        (RG_RF09_EDD,           0x7A),
        (RG_RF09_TXCUTC,        0x03),  # recommended value ()
        (RG_RF09_TXDFE,         0x46),
        (RG_RF09_PAC,           0x7B),  # Tx Power 5 bits >>. 0x64 = txPwr=>0x04, max: 0x1F. # 0x1B~8dBm
        (RG_BBC0_IRQM,          0x12),
        (RG_BBC1_IRQM,          0x00),
        (RG_BBC0_PC,            0x16),  # NO FCS FILTER in RX, FCS automatically added in TX
        (RG_BBC0_OFDMC,         0x03),
        (RG_BBC0_OFDMPHRTX,     0x04)],

    # subGHz_ofdm_4_mcs5
    'subGHz_ofdm_200kbps_200kHz_mcs5': [
        (RG_RF09_CMD,           0x02),
        (RG_RF09_IRQM,          0x1F),
        (RG_RF24_IRQM,          0x00),
        (RG_RF09_RXBWC,         0x12),
        (RG_RF09_RXDFE,         0x26),
        # (RG_RF09_AGCC,          0x11),
        (RG_RF09_EDD,           0x7A),
        (RG_RF09_TXCUTC,        0x03),  # recommended value ()
        (RG_RF09_TXDFE,         0x46),
        (RG_RF09_PAC,           0x7B),  # Tx Power 5 bits >>. 0x64 = txPwr=>0x04, max: 0x1F. # 0x1B~8dBm
        (RG_BBC0_IRQM,          0x12),
        (RG_BBC1_IRQM,          0x00),
        (RG_BBC0_PC,            0x16),  # NO FCS FILTER in RX, FCS automatically added in TX
        (RG_BBC0_OFDMC,         0x03),
        (RG_BBC0_OFDMPHRTX,     0x05)],

    # subGHz_ofdm_4_mcs6
    'subGHz_ofdm_300kbps_200kHz_mcs6': [
        (RG_RF09_CMD,           0x02),
        (RG_RF09_IRQM,          0x1F),
        (RG_RF24_IRQM,          0x00),
        (RG_RF09_RXBWC,         0x12),
        (RG_RF09_RXDFE,         0x26),
        # (RG_RF09_AGCC,          0x11),
        (RG_RF09_EDD,           0x7A),
        (RG_RF09_TXCUTC,        0x03),  # recommended value ()
        (RG_RF09_TXDFE,         0x46),
        (RG_RF09_PAC,           0x7B),  # Tx Power 5 bits >>. 0x64 = txPwr=>0x04, max: 0x1F. # 0x1B~8dBm
        (RG_BBC0_IRQM,          0x12),
        (RG_BBC1_IRQM,          0x00),
        (RG_BBC0_PC,            0x16),  # NO FCS FILTER in RX, FCS automatically added in TX
        (RG_BBC0_OFDMC,         0x03),
        (RG_BBC0_OFDMPHRTX,     0x06)],

    # legacy
    'oqpsk_250kbps_2000kHz': [
        (RG_BBC1_PC, 0x1F),
        (RG_BBC1_OQPSKPHRTX, 0x09),  # # QPSK - legacy
        (RG_BBC1_OQPSKC0, 0x03),  # # 2000 kchips/s
        (RG_BBC1_OQPSKC1, 0x47),  # MINIMUM preamble-detection sensitivities, rx-override enabled
        (RG_BBC1_OQPSKC2, 0x05),  # FCS type legacy (16bit) & listen for LEG-OQPSK frames only
        (RG_BBC1_OQPSKC3, 0x00),  # legacy OQPSK, search for SFD_1 only
        (RG_BBC0_IRQM, 0x00),  # # TXFE, RXFE, RXFS interrupts enabled
        (RG_BBC1_IRQM, 0x13),  # TXFE, RXFE, RXFS interrupts enabled
        (RG_RF09_IRQM, 0x00),  # # TRXERR, TRXRDY interrupts enabled
        (RG_RF24_IRQM, 0x12),  # TRXERR, TRXRDY interrupts enabled
        (RG_RF24_RXBWC, 0x0B),  # #  Rx BW 2000kHz, IF 2000kHz
        (RG_RF24_RXDFE, 0x41),  # #
        (RG_RF24_AGCC, 0x01),  #
        (RG_RF24_EDD, 0x13),  #
        (RG_RF24_AGCS, 0x77),  #
        (RG_RF24_TXCUTC, 0x0B),  # # .PARAMP = 3, .LPFCUT = 7
        (RG_RF24_TXDFE, 0x81),  # # .SR = 0xA, .RCUT = 3
        (RG_RF24_PAC, 0x75)], # Tx Power 5 bits >>. 0x64 = txPwr=>0x04, max: 0x1F. # 0x15~8dBm

    # 2400MHz_ofdm_1_mcs0
    '2400MHz_ofdm_100kbps_1200kHz_mcs0': [
        (RG_RF24_CMD, 0x02),
        (RG_RF09_IRQM, 0x00),
        (RG_RF24_IRQM, 0x1F),
        (RG_RF24_RXBWC, 0x1A),
        (RG_RF24_RXDFE, 0x83),
        # (RG_RF09_AGCC, 0x11),
        (RG_RF24_EDD, 0x7A),
        (RG_RF24_TXCUTC, 0x0A),  # recommended value (0x0B)
        (RG_RF24_TXDFE, 0x83),
        (RG_RF24_PAC, 0x7D),  # Tx Power 5 bits >>. 0x64 = txPwr=>0x04, max: 0x1F. # 0x1D~8dBm
        (RG_BBC0_IRQM, 0x00),
        (RG_BBC1_IRQM, 0x12),
        (RG_BBC1_PC, 0x1E),  # NO FCS FILTER in RX, FCS automatically added in TX, FCS 2 bytes
        (RG_BBC1_OFDMC, 0x00),
        (RG_BBC1_OFDMPHRTX, 0x00)],

    # 2400MHz_ofdm_1_mcs1
    '2400MHz_ofdm_200kbps_1200kHz_mcs1': [
        (RG_RF24_CMD, 0x02),
        (RG_RF09_IRQM, 0x00),
        (RG_RF24_IRQM, 0x1F),
        (RG_RF24_RXBWC, 0x1A),
        (RG_RF24_RXDFE, 0x83),
        # (RG_RF09_AGCC, 0x11),
        (RG_RF24_EDD, 0x7A),
        (RG_RF24_TXCUTC, 0x0A),  # recommended value (0x0B)
        (RG_RF24_TXDFE, 0x83),
        (RG_RF24_PAC, 0x7D),  # Tx Power 5 bits >>. 0x64 = txPwr=>0x04, max: 0x1F. # 0x1D~8dBm
        (RG_BBC0_IRQM, 0x00),
        (RG_BBC1_IRQM, 0x12),
        (RG_BBC1_PC, 0x1E),  # NO FCS FILTER in RX, FCS automatically added in TX, FCS 2 bytes
        (RG_BBC1_OFDMC, 0x00),
        (RG_BBC1_OFDMPHRTX, 0x01)],

    # 2400MHz_ofdm_1_mcs2
    '2400MHz_ofdm_400kbps_1200kHz_mcs2': [
        (RG_RF24_CMD, 0x02),
        (RG_RF09_IRQM, 0x00),
        (RG_RF24_IRQM, 0x1F),
        (RG_RF24_RXBWC, 0x1A),
        (RG_RF24_RXDFE, 0x83),
        # (RG_RF09_AGCC, 0x11),
        (RG_RF24_EDD, 0x7A),
        (RG_RF24_TXCUTC, 0x0A),  # recommended value (0x0B)
        (RG_RF24_TXDFE, 0x83),
        (RG_RF24_PAC, 0x7D),  # Tx Power 5 bits >>. 0x64 = txPwr=>0x04, max: 0x1F. # 0x1D~8dBm
        (RG_BBC0_IRQM, 0x00),
        (RG_BBC1_IRQM, 0x12),
        (RG_BBC1_PC, 0x1E),  # NO FCS FILTER in RX, FCS automatically added in TX, FCS 2 bytes
        (RG_BBC1_OFDMC, 0x00),
        (RG_BBC1_OFDMPHRTX, 0x02)],

    # 2400MHz_ofdm_1_mcs3
    '2400MHz_ofdm_800kbps_1200kHz_mcs3': [
        (RG_RF24_CMD, 0x02),
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
        (RG_BBC0_IRQM, 0x00),
        (RG_BBC1_IRQM, 0x12),
        (RG_BBC1_PC, 0x16),  # NO FCS FILTER in RX, FCS automatically added in TX
        (RG_BBC1_OFDMC, 0x03),
        (RG_BBC1_OFDMPHRTX, 0x06)]
}
