embedinn/iotSDR/(commit log)

2020-09-24 iotSDR Board Support and Documentation Files
2024-02-22 Update block_design.tcl
    updated uart and clks
2024-02-22 Update block_design.tcl
    corrections, uart and clks
2024-02-22 Update block_design.tcl
    corrected, uart and clk
2024-02-22 Update block_design.tcl
    corrected uart and clk
2024-02-22 Update block_design.tcl
    uart, updated
2024-02-28 Update README.md
    add info for boardfiles for vivado
